skiselev/74xx_clock/images/LED_Clock-Top-1.0.png

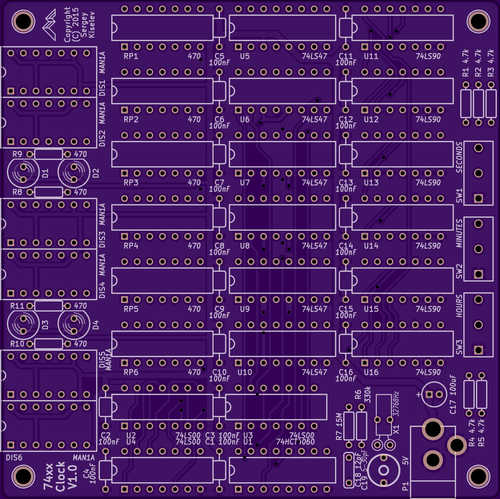
images/LED_Clock-Top-1.0.png
