skiselev/74xx_clock/STL/LED_Clock-Wall_Mount.stl

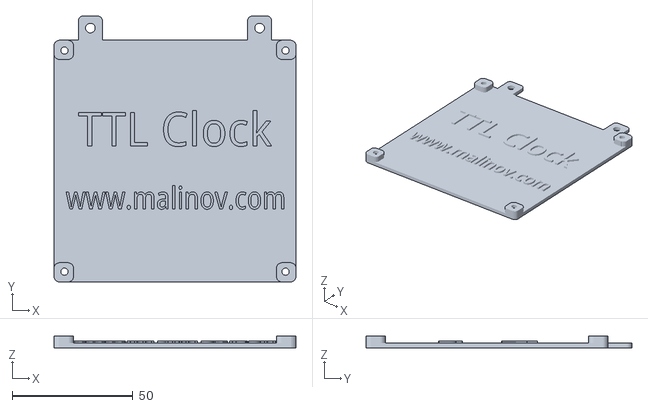
[picture p6: CAD file, 2019-02-26]
STL/LED_Clock-Wall_Mount.stl
100.0 x 110.0 x 5.00
