skiselev/74xx_clock/STL/LED_Clock-Stand.stl

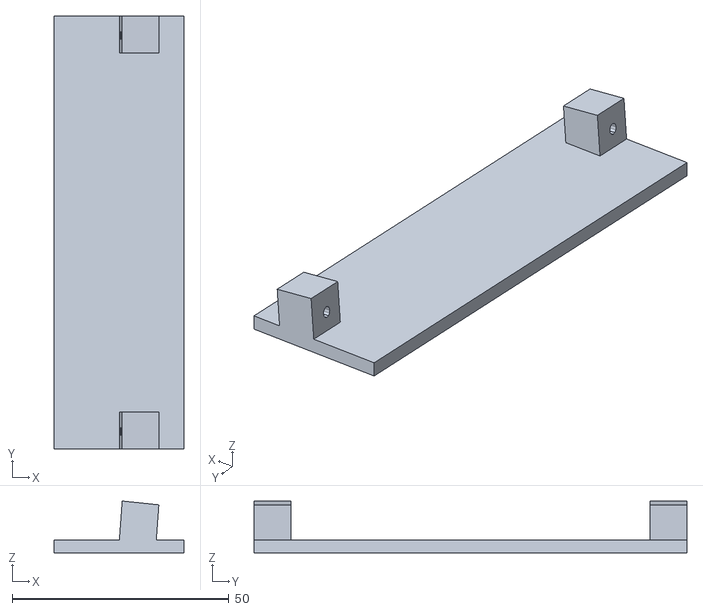
[picture p7: CAD file, 2019-02-26]
STL/LED_Clock-Stand.stl
30.0 x 100.0 x 12.0
