skiselev/74xx_clock/KiCad/LED_Clock-Schematic-1.1.pdf

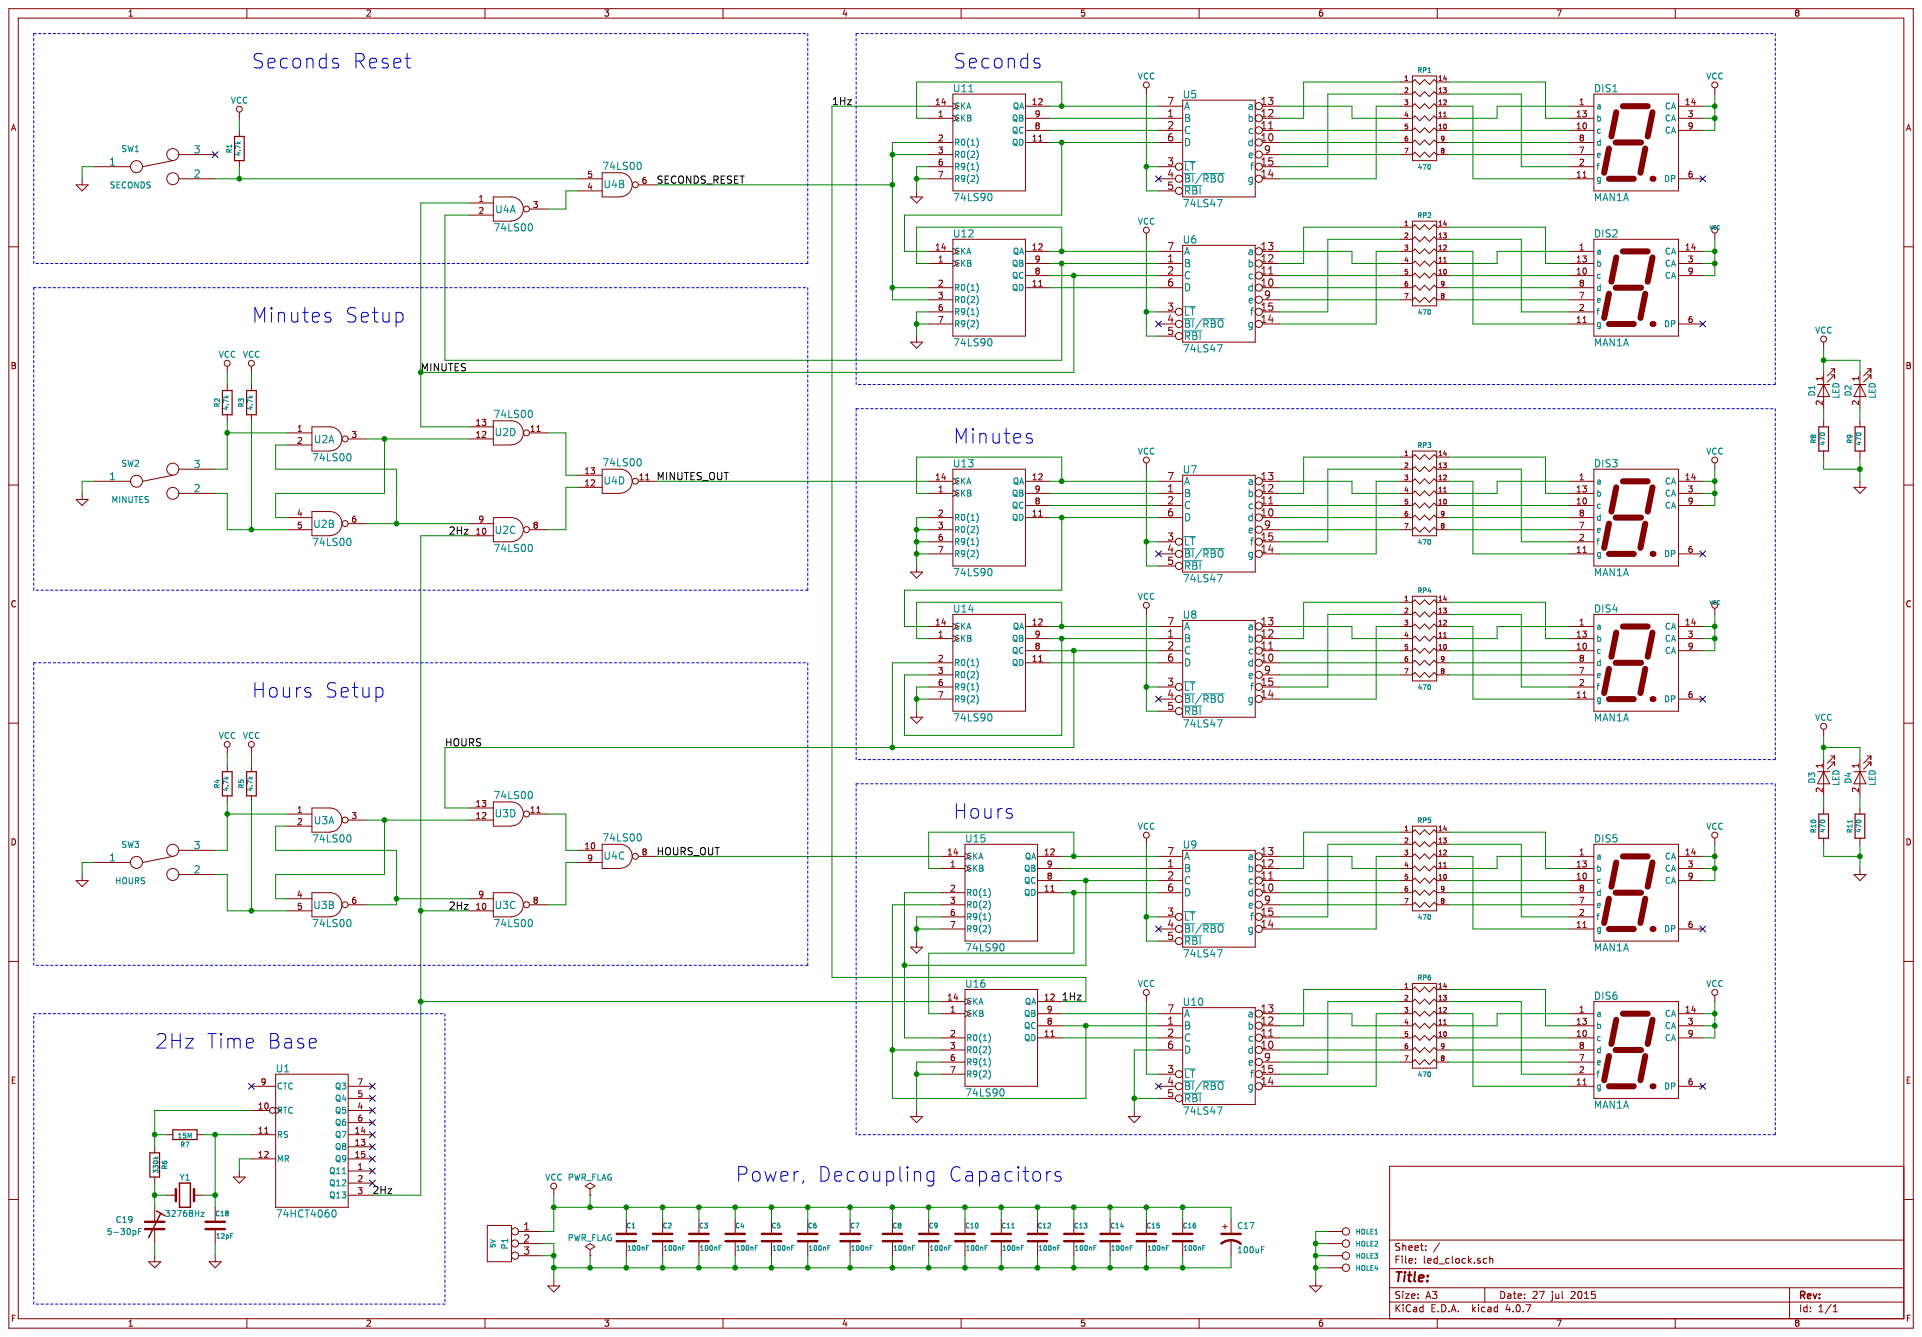
[picture p8: page 1]
