skiselev/74xx_clock/KiCad/LED_Clock-Board-1.1.pdf

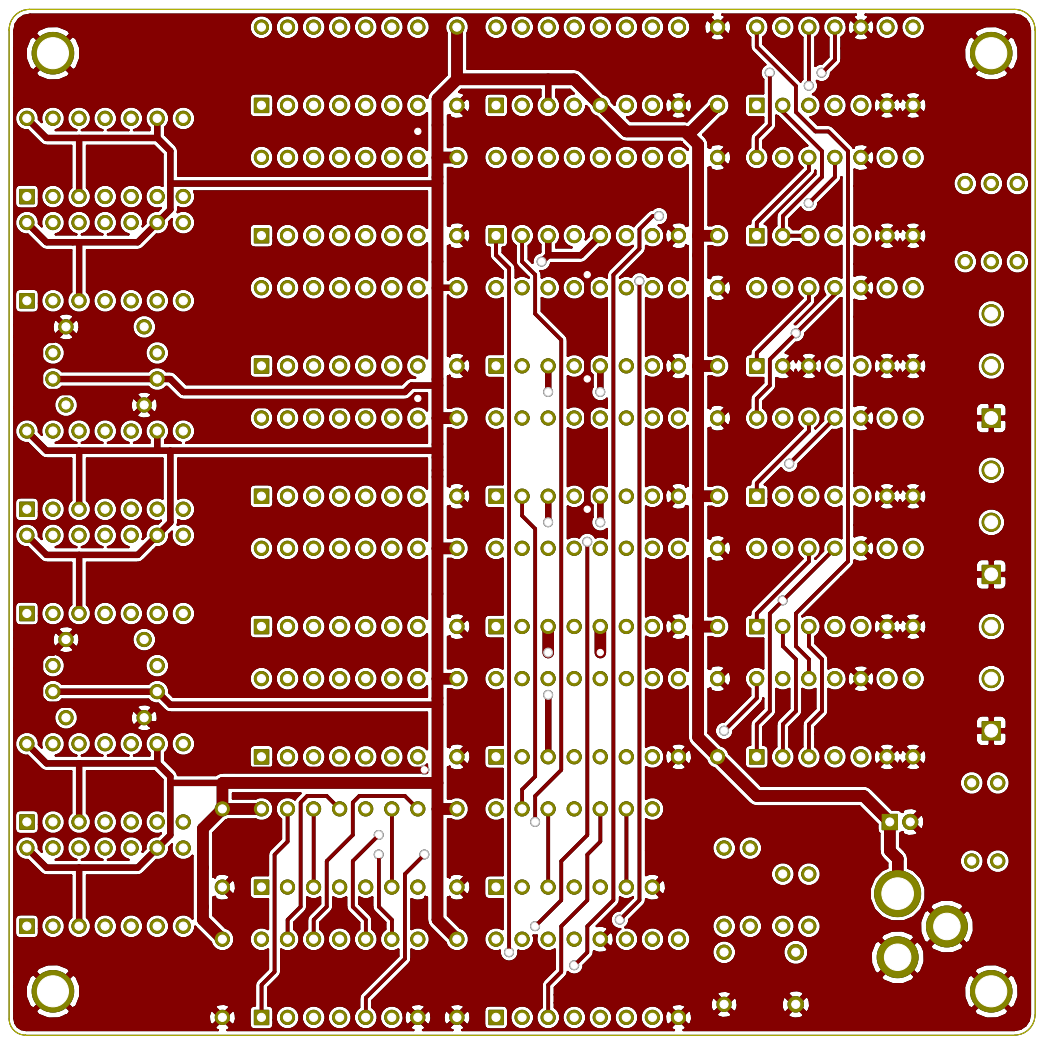
[picture p9: page 1]

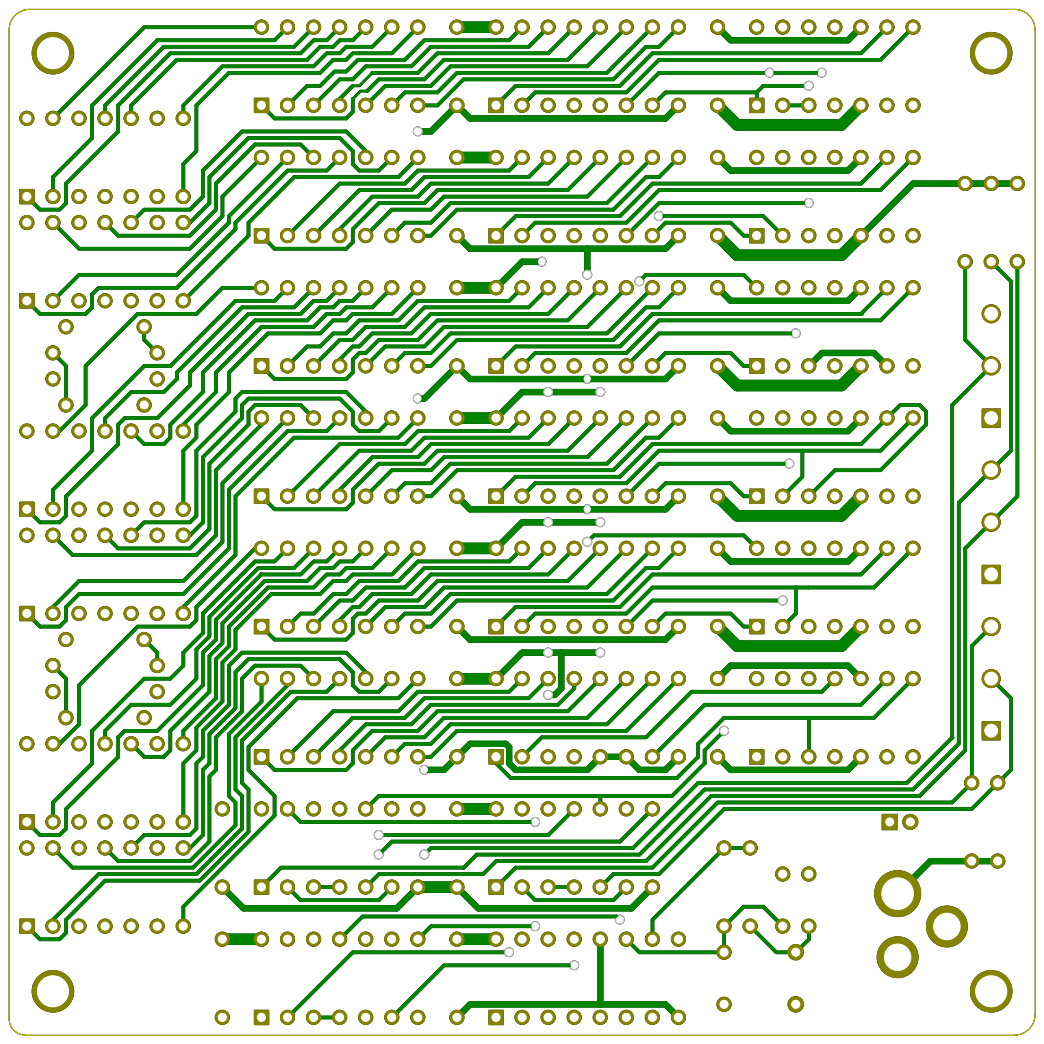
[picture p10: page 2]

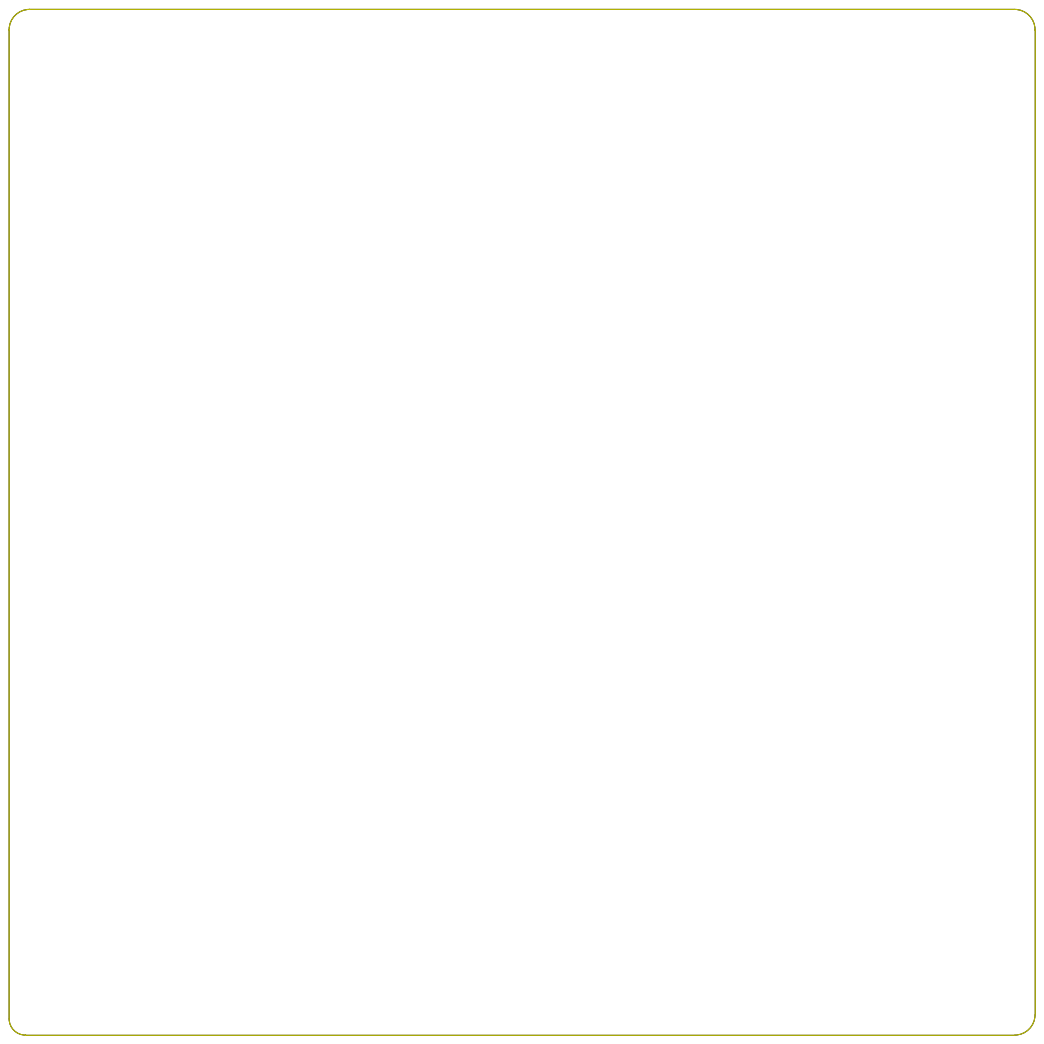
[picture p11: page 3]

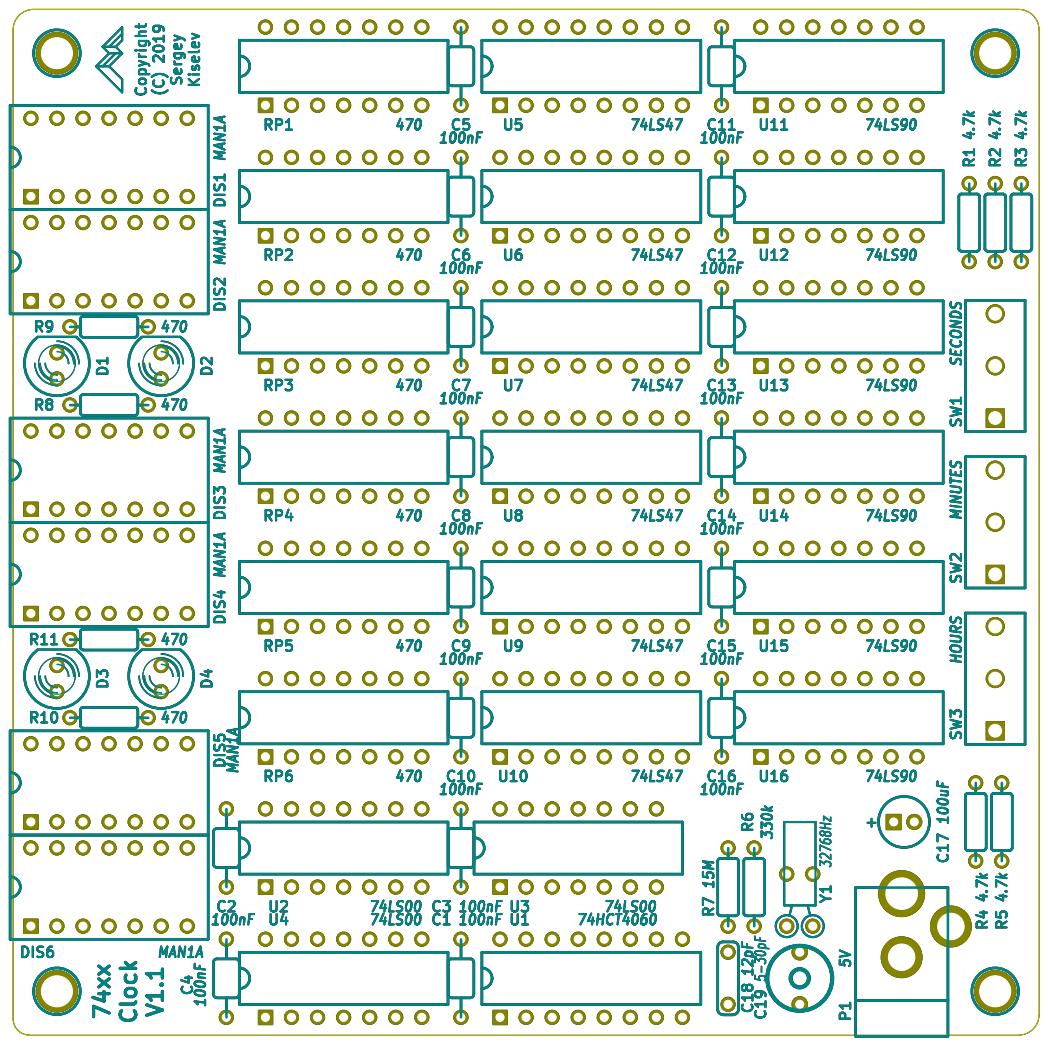
[picture p12: page 4]
