skiselev/74xx_clock/KiCad/led_clock.kicad_pcb

## KiCad design KiCad/led_clock.kicad_pcb (2019-02-26)

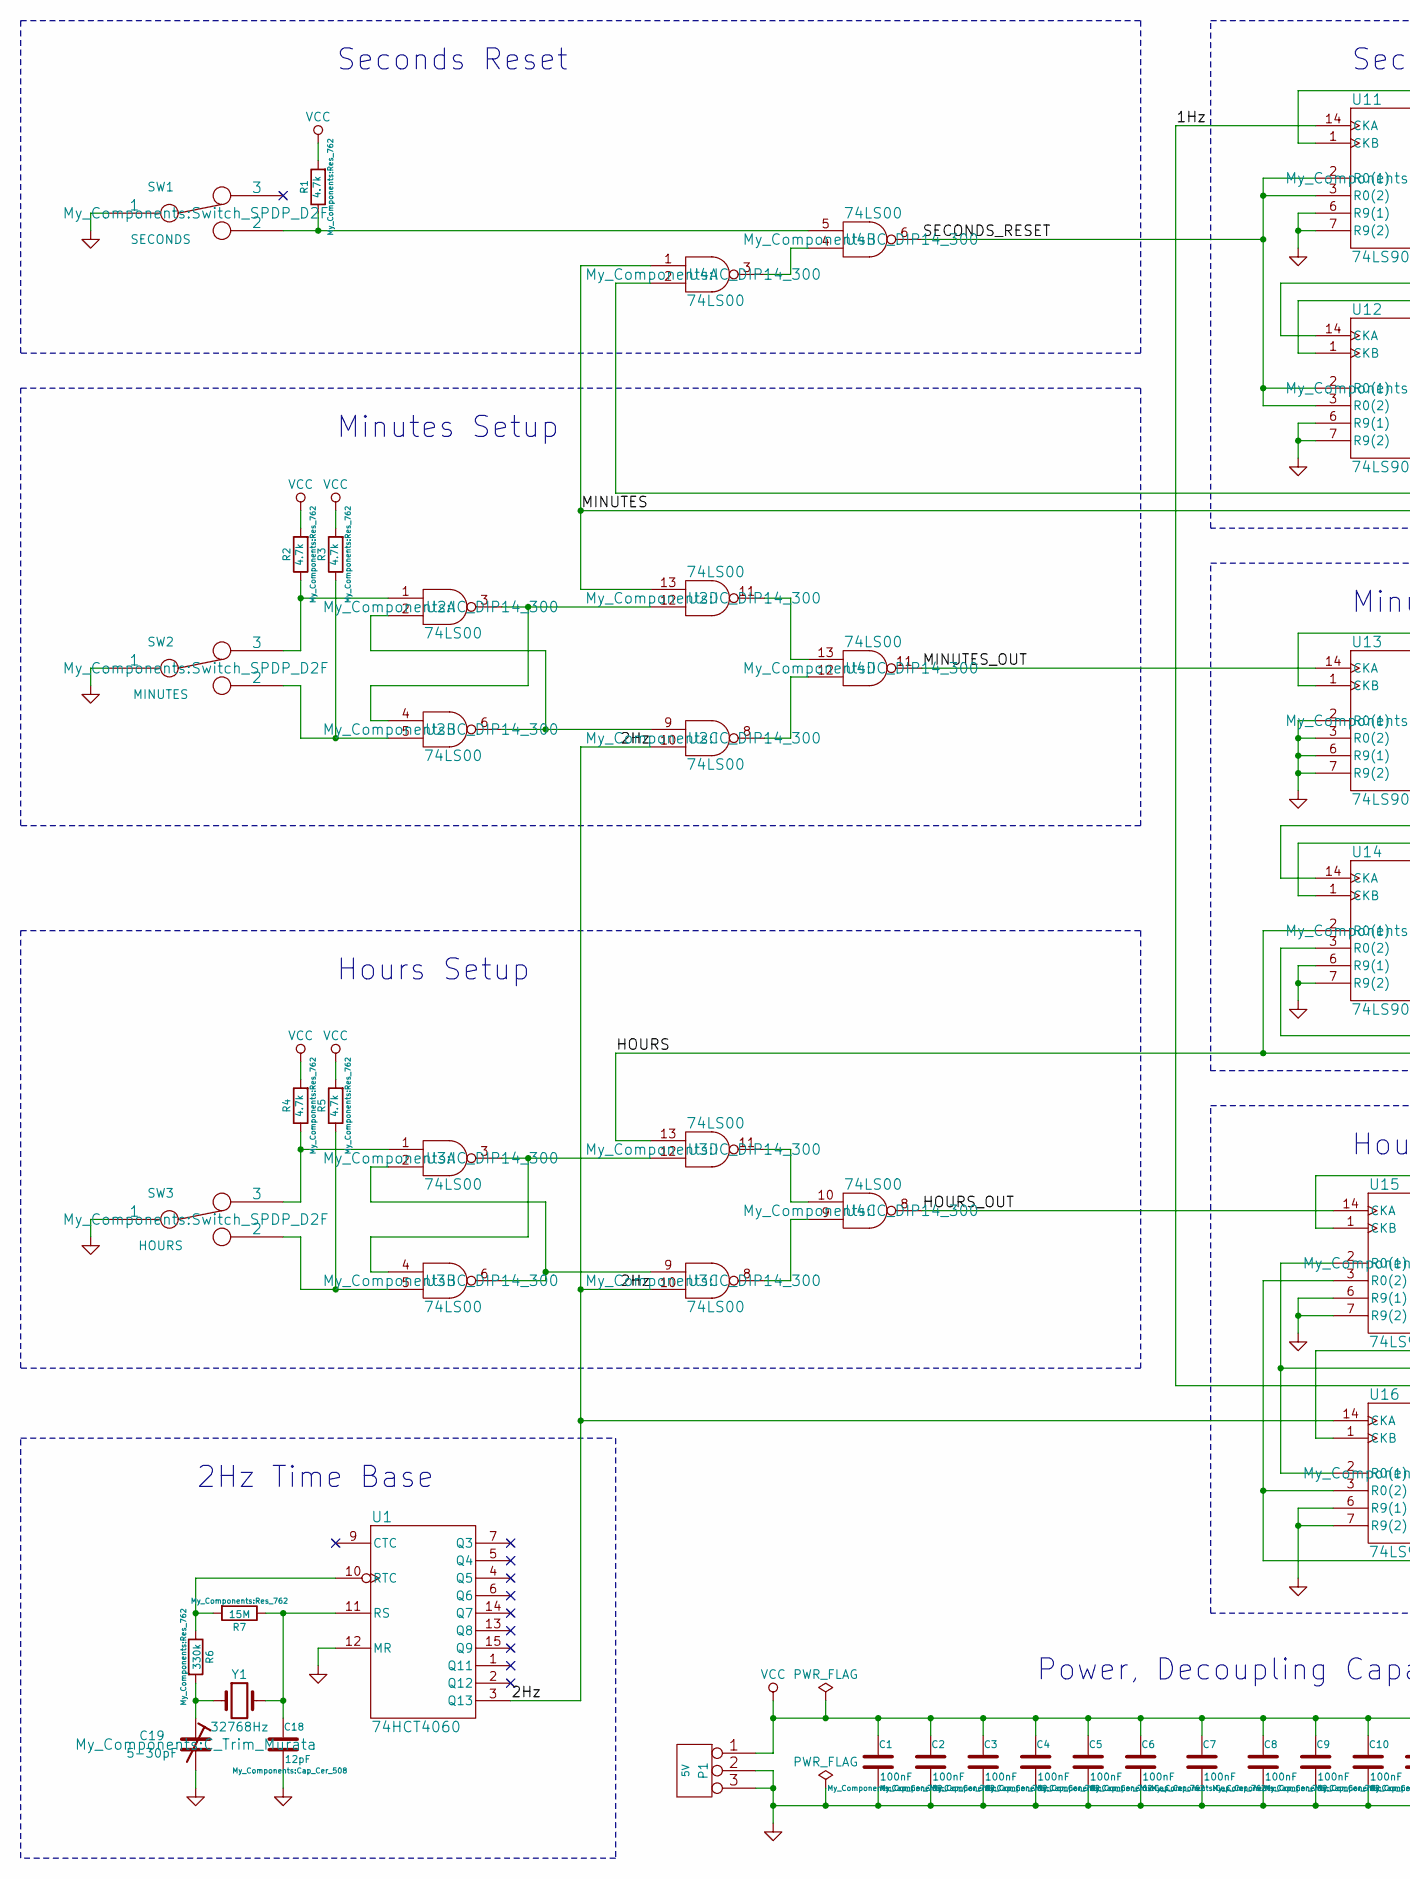
[picture p13: schematic led_clock.sch, part in row 1, column 1]

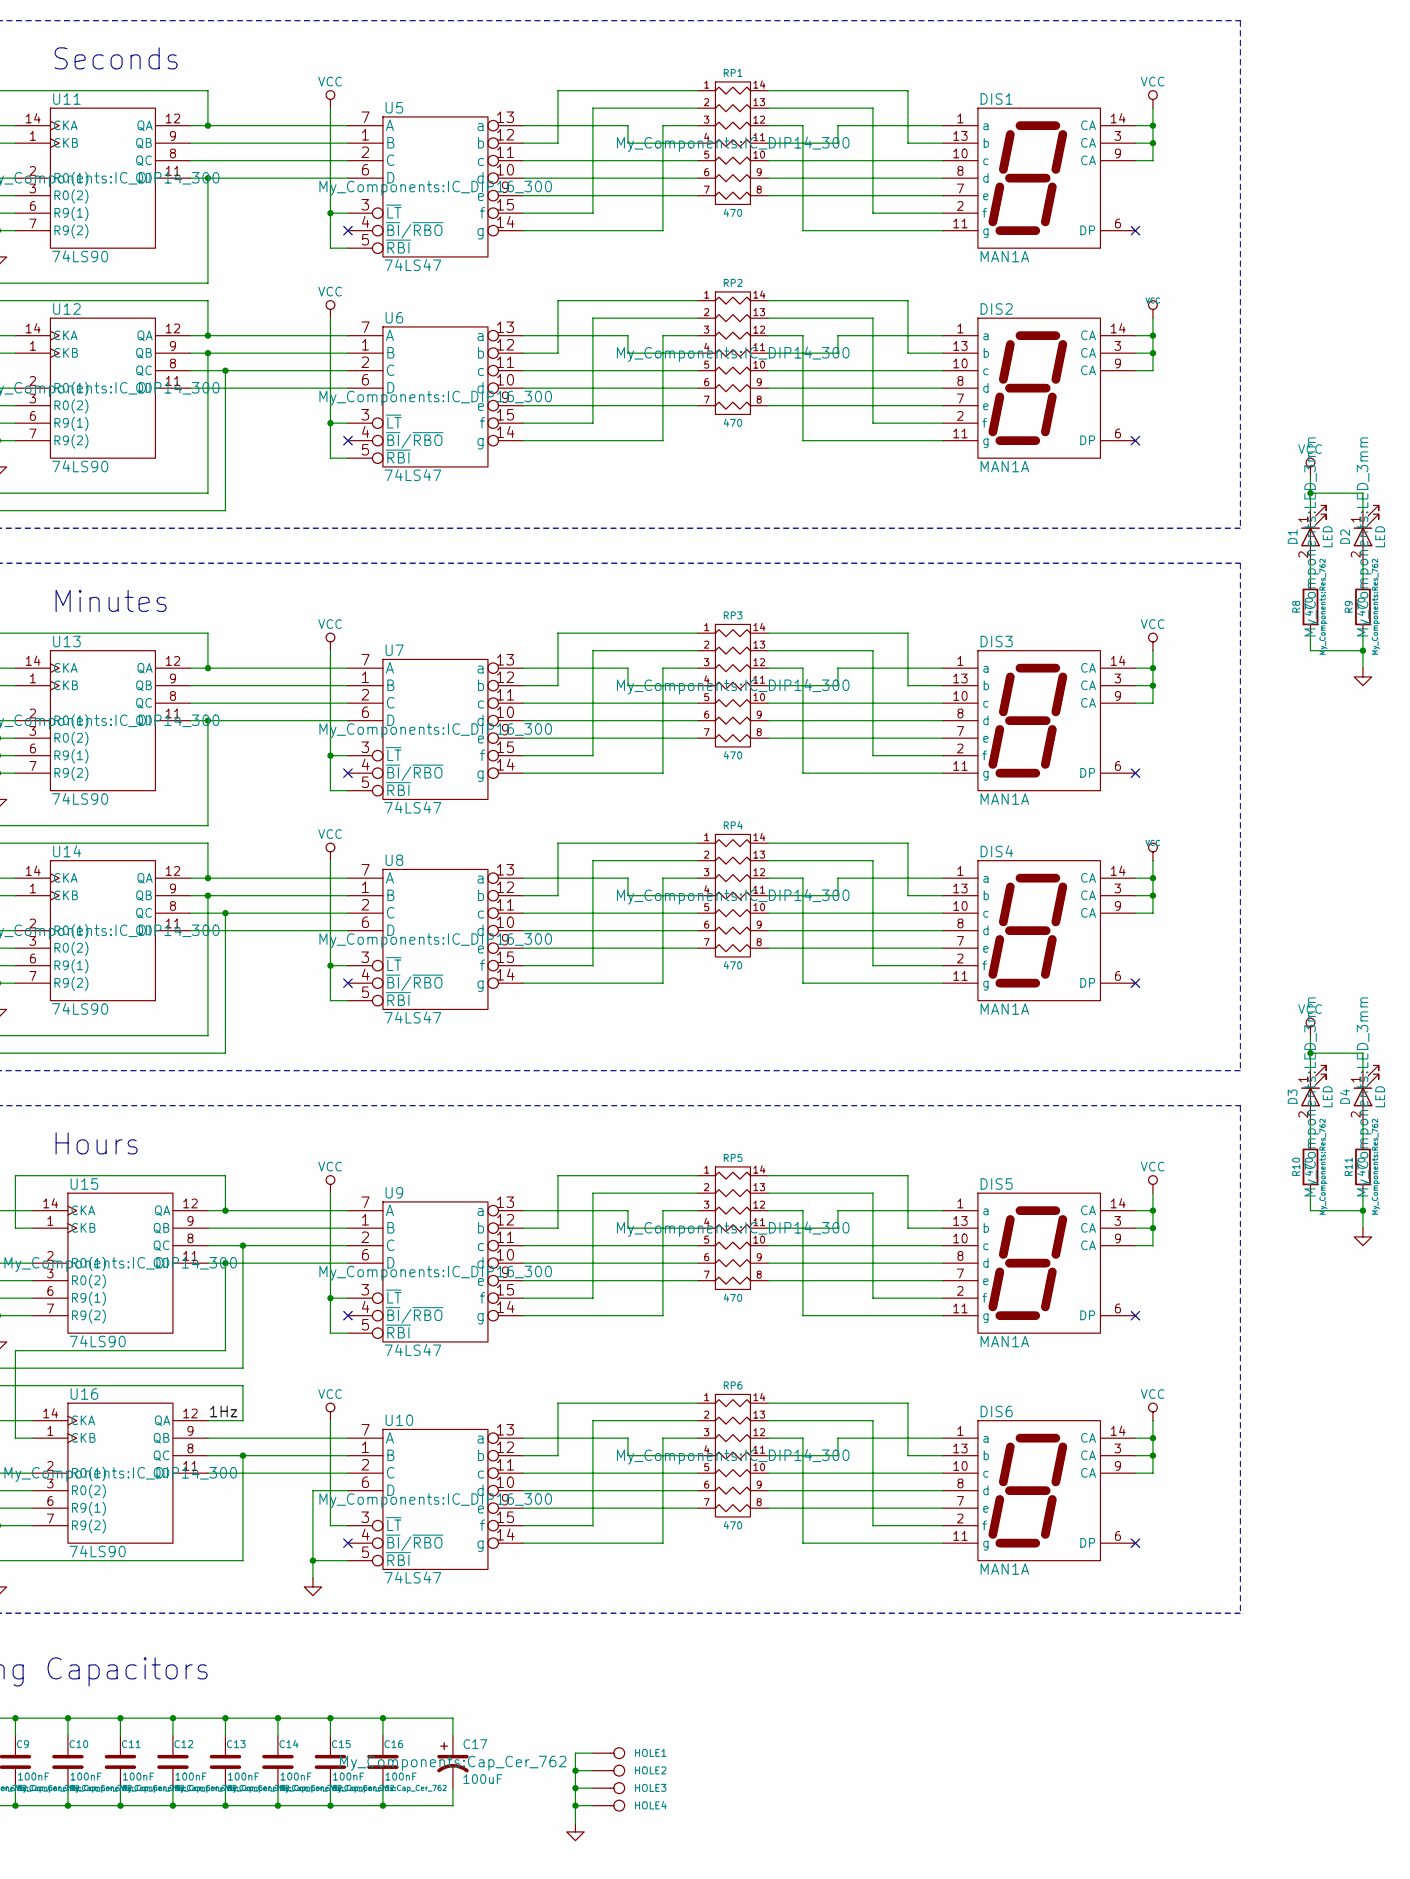
[picture p14: schematic led_clock.sch, part in row 1, column 2]

Parts:
C1, C2, C3, C4, C5, C6, C7, C8, C9, C10, C11, C12, C13, C14, C15, C16: 100nF; Cap_Cer_762
C17: 100uF; Cap_Cer_762
C18: 12pF; Cap_Cer_508
C19: 5-30pF; C_Trim_Murata
D1, D2, D3, D4: LED; LED_3mm
DIS1, DIS2, DIS3, DIS4, DIS5, DIS6: MAN1A; Display_LED7_DIP14_300
HOLE1, HOLE2, HOLE3, HOLE4: CONN_1; Hole_3mm
P1: 5V; Conn_Power_Jack_Circular_Pads
R1, R2, R3, R4, R5: 4.7k; Res_762
R6: 330k; Res_762
R7: 15M; Res_762
R8, R9, R10, R11: 470; Res_762
RP1, RP2, RP3, RP4, RP5, RP6: 470; IC_DIP14_300
SW1: SECONDS; Switch_SPDP_D2F
SW2: MINUTES; Switch_SPDP_D2F
SW3: HOURS; Switch_SPDP_D2F
U1: 74HCT4060; IC_DIP16_300
U2, U3, U4: 74LS00; IC_DIP14_300
U5, U6, U7, U8, U9, U10: 74LS47; IC_DIP16_300
U11, U12, U13, U14, U15, U16: 74LS90; IC_DIP14_300
Y1: 32768Hz; Crystal_32K_Horiz

Connections:
/1Hz: U11.14 (CKA), U16.12 (QA)
/2Hz: U1.3 (Q13), U2.10, U3.10, U16.14 (CKA)
/HOURS: U3.13, U8.2 (C), U14.2 (R0(1)), U14.8 (QC)
/HOURS_OUT: U4.8, U15.14 (CKA)
/MINUTES: U2.13, U4.1, U6.2 (C), U12.8 (QC)
/MINUTES_OUT: U4.11, U13.14 (CKA)
/SECONDS_RESET: U4.6, U11.2 (R0(1)), U11.3 (R0(2)), U12.2 (R0(1)), U12.3 (R0(2))
GND: C1.2, C2.2, C3.2, C4.2, C5.2, C6.2, C7.2, C8.2, C9.2, C10.2, C11.2, C12.2, C13.2, C14.2, C15.2, C16.2, C17.2, C18.2, C19.2, HOLE1.1, HOLE2.1, HOLE3.1, HOLE4.1, P1.2 (PM), P1.3, R8.2, R9.2, R10.2, R11.2, SW1.1, SW2.1, SW3.1, U1.8 (GND), U1.12 (MR), U2.7 (GND), U3.7 (GND), U4.7 (GND), U5.8 (GND), U6.8 (GND), U7.8 (GND), U8.8 (GND), U9.8 (GND), U10.5 (~RBI), U10.6 (D), U10.8 (GND), U11.6 (R9(1)), U11.7 (R9(2)), U11.10 (GND), U12.6 (R9(1)), U12.7 (R9(2)), U12.10 (GND), U13.2 (R0(1)), U13.3 (R0(2)), U13.6 (R9(1)), U13.7 (R9(2)), U13.10 (GND), U14.6 (R9(1)), U14.7 (R9(2)), U14.10 (GND), U15.6 (R9(1)), U15.7 (R9(2)), U15.10 (GND), U16.6 (R9(1)), U16.7 (R9(2)), U16.10 (GND)
unnamed: C18.1, R7.1, U1.11 (RS), Y1.2
unnamed: C19.1, R6.2, Y1.1
unnamed: D1.2 (A), R8.1
unnamed: D2.2 (A), R9.1
unnamed: D3.2 (A), R10.1
unnamed: D4.2 (A), R11.1
unnamed: DIS1.1 (a), RP1.11 (R6)
unnamed: DIS1.2 (f), RP1.13 (R4)
unnamed: DIS1.7 (e), RP1.8
unnamed: DIS1.8 (d), RP1.9 (R8)
unnamed: DIS1.10 (c), RP1.10 (R7)
unnamed: DIS1.11 (g), RP1.12 (R5)
unnamed: DIS1.13 (b), RP1.14 (R3)
unnamed: DIS2.1 (a), RP2.11 (R6)
unnamed: DIS2.2 (f), RP2.13 (R4)
unnamed: DIS2.7 (e), RP2.8
unnamed: DIS2.8 (d), RP2.9 (R8)
unnamed: DIS2.10 (c), RP2.10 (R7)
unnamed: DIS2.11 (g), RP2.12 (R5)
unnamed: DIS2.13 (b), RP2.14 (R3)
unnamed: DIS3.1 (a), RP3.11 (R6)
unnamed: DIS3.2 (f), RP3.13 (R4)
unnamed: DIS3.7 (e), RP3.8
unnamed: DIS3.8 (d), RP3.9 (R8)
unnamed: DIS3.10 (c), RP3.10 (R7)
unnamed: DIS3.11 (g), RP3.12 (R5)
unnamed: DIS3.13 (b), RP3.14 (R3)
unnamed: DIS4.1 (a), RP4.11 (R6)
unnamed: DIS4.2 (f), RP4.13 (R4)
unnamed: DIS4.7 (e), RP4.8
unnamed: DIS4.8 (d), RP4.9 (R8)
unnamed: DIS4.10 (c), RP4.10 (R7)
unnamed: DIS4.11 (g), RP4.12 (R5)
unnamed: DIS4.13 (b), RP4.14 (R3)
unnamed: DIS5.1 (a), RP5.11 (R6)
unnamed: DIS5.2 (f), RP5.13 (R4)
unnamed: DIS5.7 (e), RP5.8
unnamed: DIS5.8 (d), RP5.9 (R8)
unnamed: DIS5.10 (c), RP5.10 (R7)
unnamed: DIS5.11 (g), RP5.12 (R5)
unnamed: DIS5.13 (b), RP5.14 (R3)
unnamed: DIS6.1 (a), RP6.11 (R6)
unnamed: DIS6.2 (f), RP6.13 (R4)
unnamed: DIS6.7 (e), RP6.8
unnamed: DIS6.8 (d), RP6.9 (R8)
unnamed: DIS6.10 (c), RP6.10 (R7)
unnamed: DIS6.11 (g), RP6.12 (R5)
unnamed: DIS6.13 (b), RP6.14 (R3)
unnamed: R1.1, SW1.2, U4.5
unnamed: R2.1, SW2.3, U2.1
unnamed: R3.1, SW2.2, U2.5
unnamed: R4.1, SW3.3, U3.1
unnamed: R5.1, SW3.2, U3.5
unnamed: R6.1, R7.2, U1.10 (RTC)
unnamed: RP1.1, U5.12 (b)
unnamed: RP1.2, U5.15 (f)
unnamed: RP1.3, U5.14 (g)
unnamed: RP1.4, U5.13 (a)
unnamed: RP1.5, U5.11 (c)
unnamed: RP1.6, U5.10 (d)
unnamed: RP1.7, U5.9 (e)
unnamed: RP2.1, U6.12 (b)
unnamed: RP2.2, U6.15 (f)
unnamed: RP2.3, U6.14 (g)
unnamed: RP2.4, U6.13 (a)
unnamed: RP2.5, U6.11 (c)
unnamed: RP2.6, U6.10 (d)
unnamed: RP2.7, U6.9 (e)
unnamed: RP3.1, U7.12 (b)
unnamed: RP3.2, U7.15 (f)
unnamed: RP3.3, U7.14 (g)
unnamed: RP3.4, U7.13 (a)
unnamed: RP3.5, U7.11 (c)
unnamed: RP3.6, U7.10 (d)
unnamed: RP3.7, U7.9 (e)
unnamed: RP4.1, U8.12 (b)
unnamed: RP4.2, U8.15 (f)
unnamed: RP4.3, U8.14 (g)
unnamed: RP4.4, U8.13 (a)
unnamed: RP4.5, U8.11 (c)
unnamed: RP4.6, U8.10 (d)
unnamed: RP4.7, U8.9 (e)
unnamed: RP5.1, U9.12 (b)
unnamed: RP5.2, U9.15 (f)
unnamed: RP5.3, U9.14 (g)
unnamed: RP5.4, U9.13 (a)
unnamed: RP5.5, U9.11 (c)
unnamed: RP5.6, U9.10 (d)
unnamed: RP5.7, U9.9 (e)
unnamed: RP6.1, U10.12 (b)
unnamed: RP6.2, U10.15 (f)
unnamed: RP6.3, U10.14 (g)
unnamed: RP6.4, U10.13 (a)
unnamed: RP6.5, U10.11 (c)
unnamed: RP6.6, U10.10 (d)
unnamed: RP6.7, U10.9 (e)
unnamed: U2.2, U2.6, U2.9
unnamed: U2.8, U4.12
unnamed: U2.11, U4.13
unnamed: U2.3, U2.4, U2.12
unnamed: U3.2, U3.6, U3.9
unnamed: U3.8, U4.9
unnamed: U3.11, U4.10
unnamed: U3.3, U3.4, U3.12
unnamed: U4.3, U4.4
unnamed: U10.1 (B), U15.3 (R0(2)), U16.3 (R0(2)), U16.8 (QC)
unnamed: U10.2 (C), U16.11 (QD)
unnamed: U10.7 (A), U16.9 (QB)
unnamed: U5.7 (A), U11.1 (CKB), U11.12 (QA)
unnamed: U5.2 (C), U11.8 (QC)
unnamed: U5.1 (B), U11.9 (QB)
unnamed: U5.6 (D), U11.11 (QD), U12.14 (CKA)
unnamed: U6.7 (A), U12.1 (CKB), U12.12 (QA)
unnamed: U4.2, U6.1 (B), U12.9 (QB)
unnamed: U6.6 (D), U12.11 (QD)
unnamed: U7.7 (A), U13.1 (CKB), U13.12 (QA)
unnamed: U7.2 (C), U13.8 (QC)
unnamed: U7.1 (B), U13.9 (QB)
unnamed: U7.6 (D), U13.11 (QD), U14.14 (CKA)
unnamed: U8.7 (A), U14.1 (CKB), U14.12 (QA)
unnamed: U8.1 (B), U14.3 (R0(2)), U14.9 (QB)
unnamed: U8.6 (D), U14.11 (QD)
unnamed: U9.7 (A), U15.1 (CKB), U15.12 (QA)
unnamed: U9.2 (C), U15.2 (R0(1)), U15.8 (QC), U16.2 (R0(1))
unnamed: U9.1 (B), U15.9 (QB)
unnamed: U9.6 (D), U15.11 (QD), U16.1 (CKB)
VCC: C1.1, C2.1, C3.1, C4.1, C5.1, C6.1, C7.1, C8.1, C9.1, C10.1, C11.1, C12.1, C13.1, C14.1, C15.1, C16.1, C17.1, D1.1 (K), D2.1 (K), D3.1 (K), D4.1 (K), DIS1.3 (CA), DIS1.9 (CA), DIS1.14 (CA), DIS2.3 (CA), DIS2.9 (CA), DIS2.14 (CA), DIS3.3 (CA), DIS3.9 (CA), DIS3.14 (CA), DIS4.3 (CA), DIS4.9 (CA), DIS4.14 (CA), DIS5.3 (CA), DIS5.9 (CA), DIS5.14 (CA), DIS6.3 (CA), DIS6.9 (CA), DIS6.14 (CA), P1.1, R1.2, R2.2, R3.2, R4.2, R5.2, U1.16 (VCC), U2.14 (VCC), U3.14 (VCC), U4.14 (VCC), U5.3 (~LT), U5.5 (~RBI), U5.16 (VCC), U6.3 (~LT), U6.5 (~RBI), U6.16 (VCC), U7.3 (~LT), U7.5 (~RBI), U7.16 (VCC), U8.3 (~LT), U8.5 (~RBI), U8.16 (VCC), U9.3 (~LT), U9.5 (~RBI), U9.16 (VCC), U10.3 (~LT), U10.16 (VCC), U11.5 (VCC), U12.5 (VCC), U13.5 (VCC), U14.5 (VCC), U15.5 (VCC), U16.5 (VCC)

Notes on the sheet:
Seconds
Minutes
Hours
Power, Decoupling Capacitors
2Hz Time Base
Hours Setup
Minutes Setup
Seconds Reset

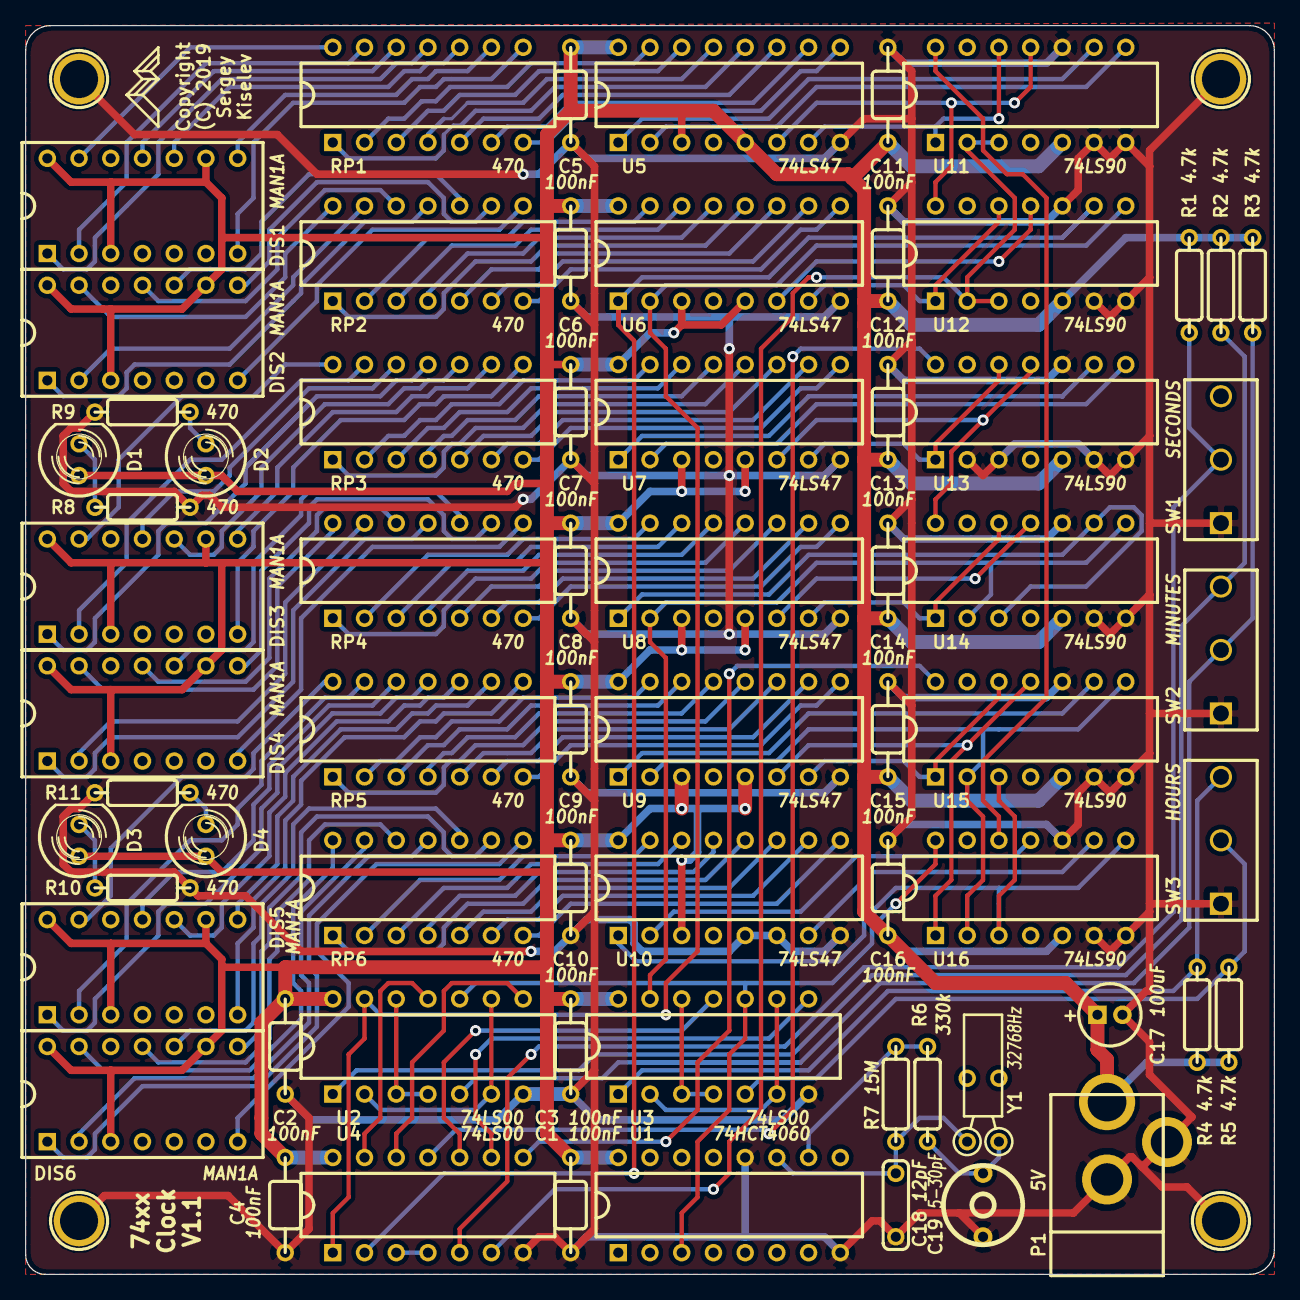
[picture p15: board led_clock.kicad_pcb from above]

Board: 2 copper layers, 100.0 x 100.0 mm, 71 parts (0 on the bottom side), 135 nets.
