skiselev/74xx_clock/(commit log)

2019-02-26 Add files for version 1.0
    [led_clock.kicad_pcb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]
2019-02-26 Add STL files for the stand and wall mount
    [LED_Clock-Stand.stl, LED_Clock-Wall_Mount.stl]
2019-02-26 Add files for version 1.1
    [led_clock-B.Cu.gbl, led_clock-B.Mask.gbs, led_clock-B.SilkS.gbo, led_clock-B_Cu.gbl, led_clock-B_Mask.gbs, led_clock-Edge.Cuts.gm1, led_clock-Edge_Cuts.gbr, led_clock-F.Cu.gtl]
2019-02-26 Hide footprint fields in the schematic
    [led_clock.sch]
2019-02-26 Use dual digit display
    [led_clock.sch]
