skiselev/74xx_clock/(notices)

Notices in the files:
KiCad/led_clock.kicad_pcb:
(C) 2019
